danmincu/Volleyball-scoreboard/MountingEverything.PNG

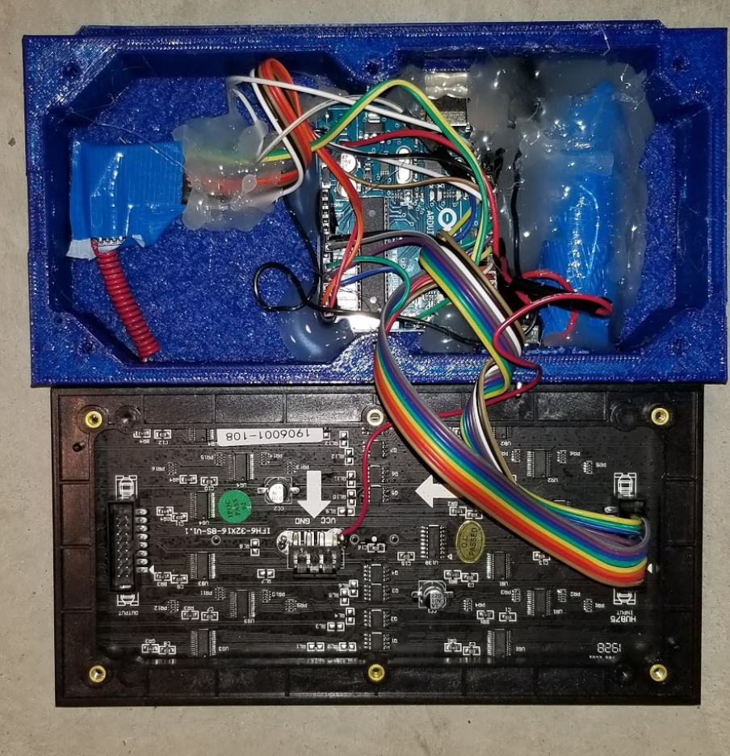
MountingEverything.PNG
