danmincu/Volleyball-scoreboard/materials.png

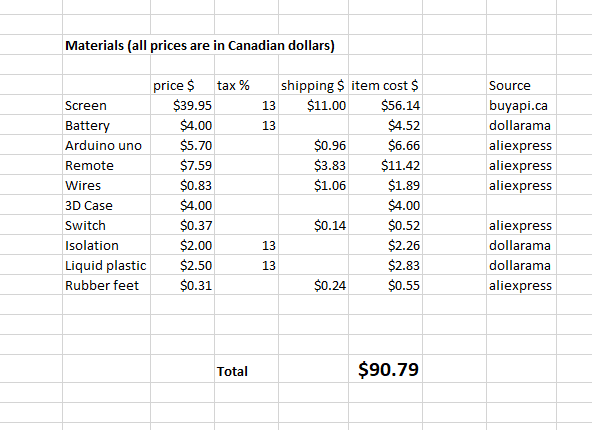
materials.png
