danmincu/Volleyball-scoreboard/(commit log)

2019-10-15 Fix a bug
    The bug where the winning animation shows even when the score is decreased!
    [score-board.ino]
2019-10-15 Show server
    Added a less than perfect shows the server and counts when 5 in a row serves are won displayin the next serve with RED.
    There are situations when the score is decreased when the serve is not correctly display the only solution is to stack the results but due to lack of time this hasn't been done (yet)
    [score-board.ino]
